ofauchon/oflmotes/README.md

# oflmotes

New 802.15.4 Sensor Network Framework.
OFLmotes is is the sucessor of OFLmetrics project. 

It's a full rewrite of both embedded firmwares and server code. 
It's now based on RIOT-OS, Golang.
