ofauchon/oflmotes/mote-devboard/README.md

# v1.0 Hardware 

First design, proof of concept.

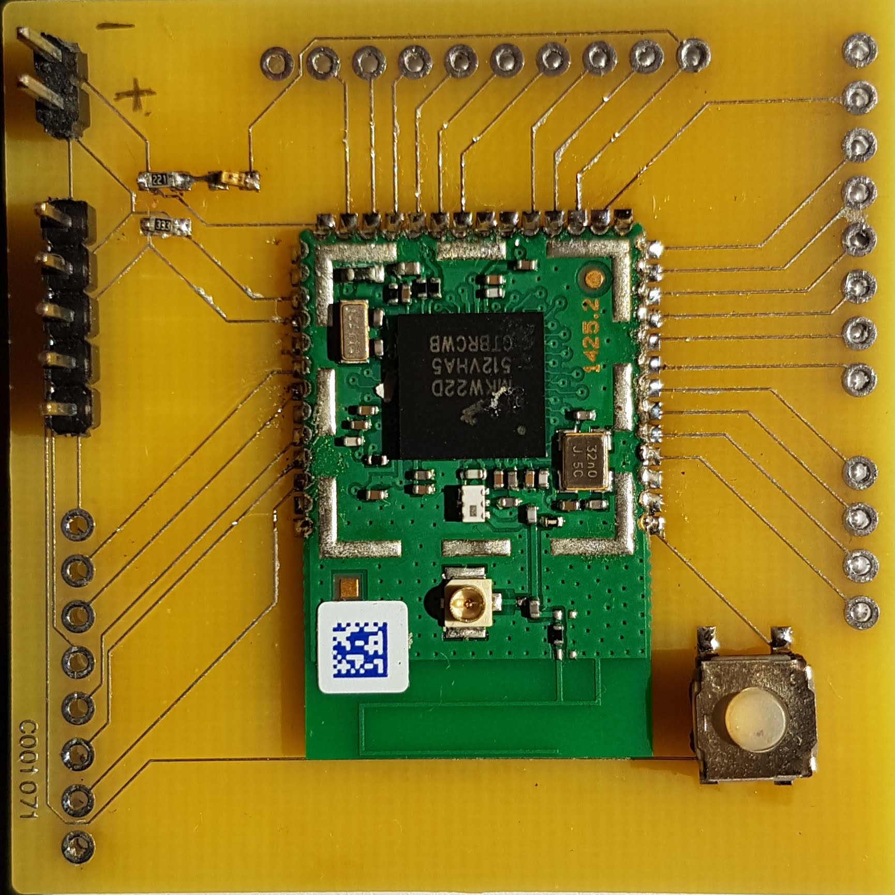
[picture p1: mote-devboard/res/board_v1.0.jpg]
v1.0 board picture


# v2.0 Hardware
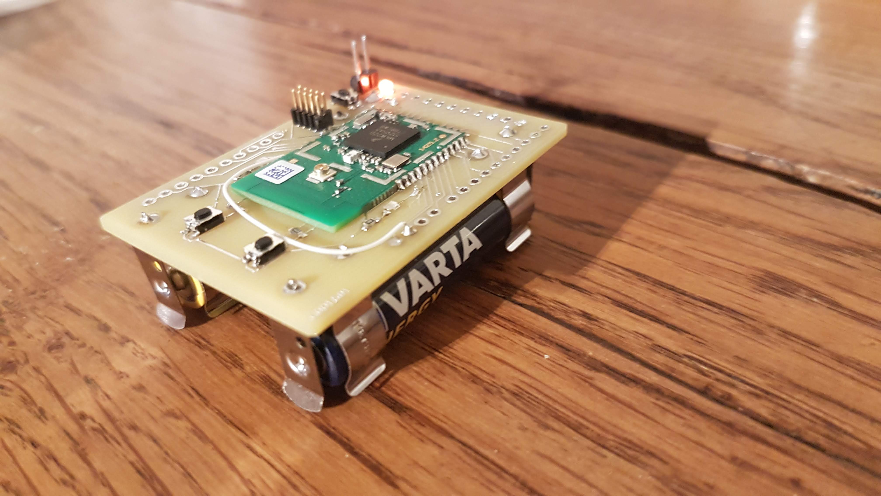
[picture p2: mote-devboard/res/board_v2.0.jpg]
v2.0 board picture

<!--<img src="kw2xd_module_pinout.png" alt="KW2xD module pinout" width="400px"/>-->

Enhancements: 

- 1 Led connected to power
- 2 Leds connected to GPIO
- 2 Buttons connected to GPIO
- Reduced board size
- AAA Batteries Support
