ofauchon/oflmotes/mote-devboard/circuit/v2/README.md

v2.0

  - New design with more led, buttons, AAA Batteries

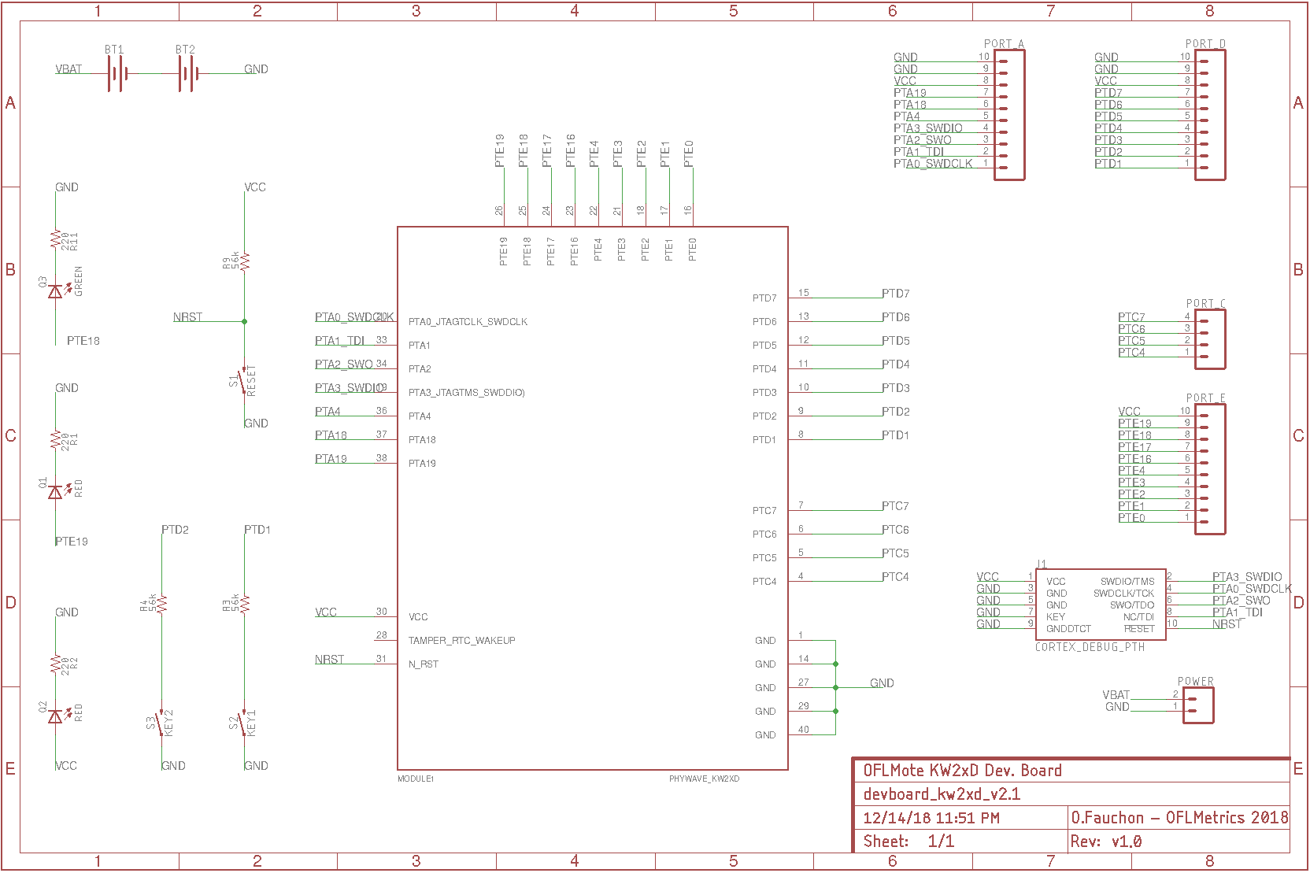
[picture p3: mote-devboard/circuit/v2/devboard_kw2xd_circuit_v2.0.png]
v2.0 board circuit

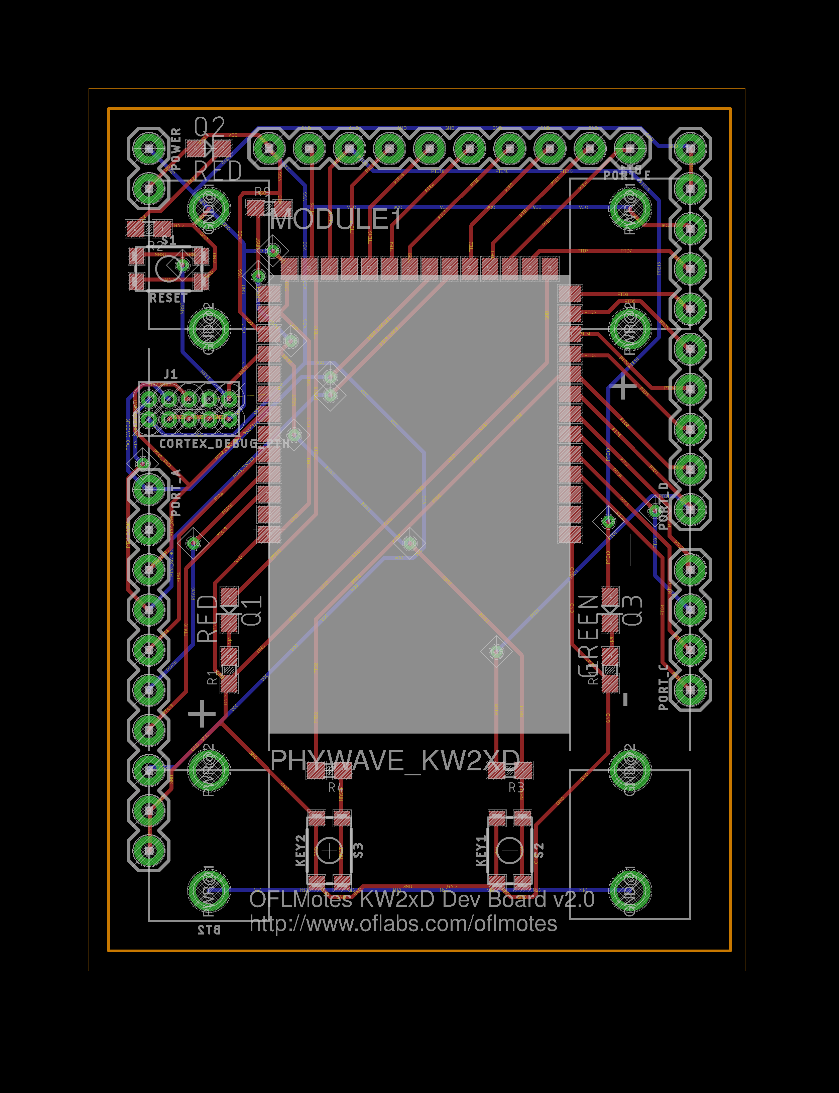
[picture p4: mote-devboard/circuit/v2/devboard_kw2xd_board_v2.0.png]
v2.0 board


Manufactured batch of 5 boards on nov 2018.

v2.1 (Work in progress) 

  - Add Restrict / Keepouts areas on Phynode module
  - Don't use  PTE18/PTE19 for LED1/2 as it can't be used as  GPIO :-(  
  - Top Left 2 pin headers can be used to switch on/off or for current measurement

v2.1 board circuit
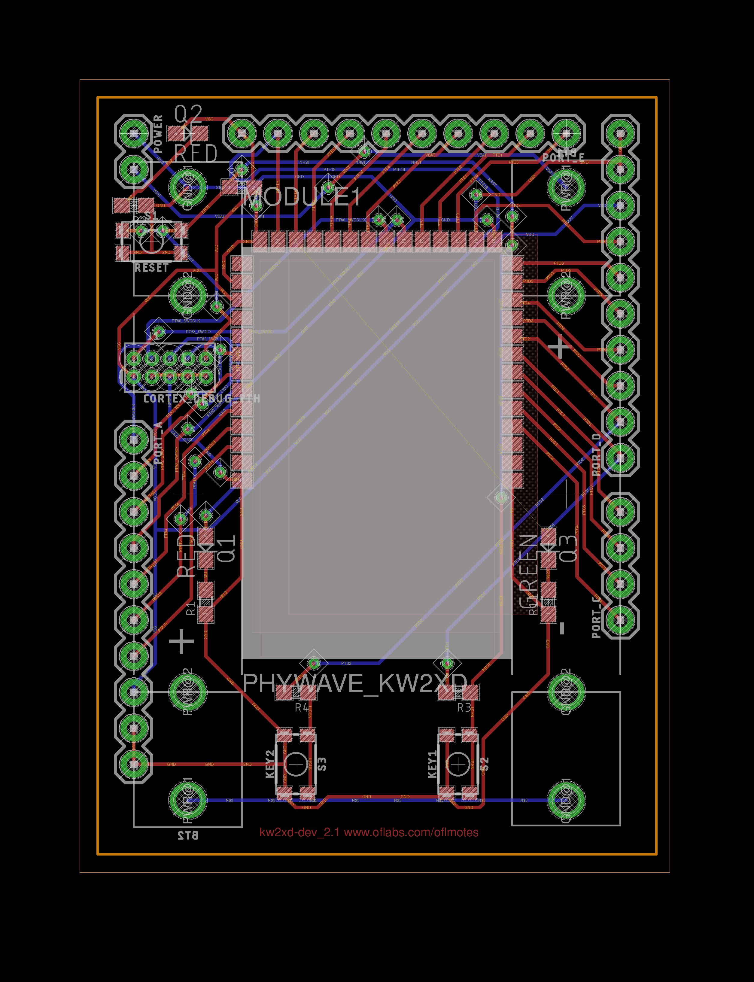
[picture p5: mote-devboard/circuit/v2/devboard_kw2xd_board_v2.1.png]
v2.1 board
