ofauchon/oflmotes/mote-devboard/res/kw2xd_module_pinout.png

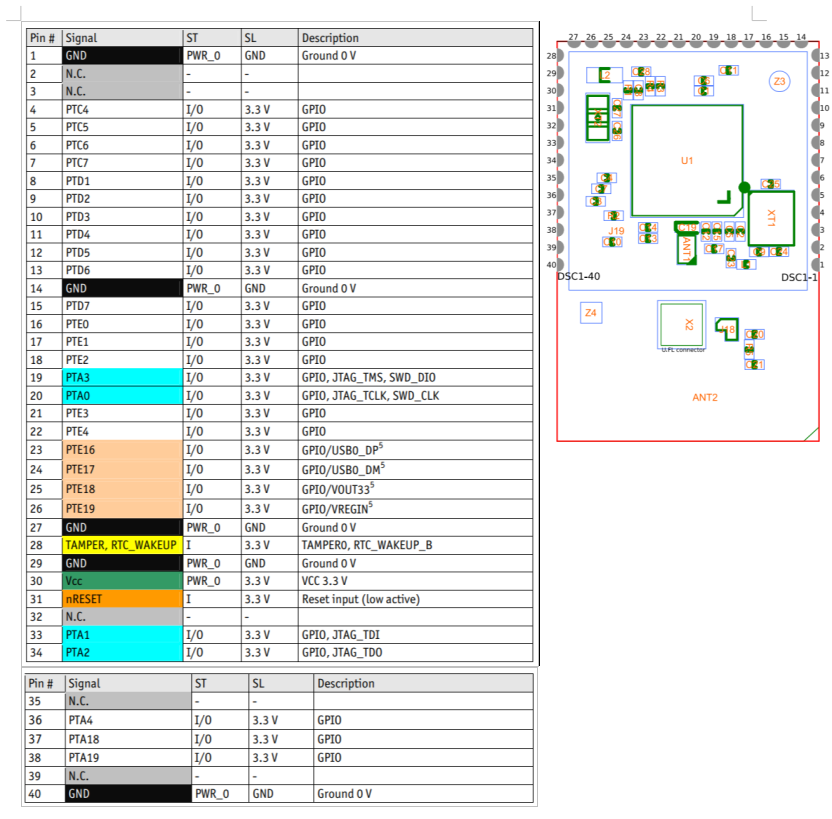
mote-devboard/res/kw2xd_module_pinout.png
