ofauchon/oflmotes/mote-devboard/circuit/v2/devboard_kw2xd_v2.1.brd

## EAGLE design mote-devboard/circuit/v2/devboard_kw2xd_v2.1.brd (2019-01-01)

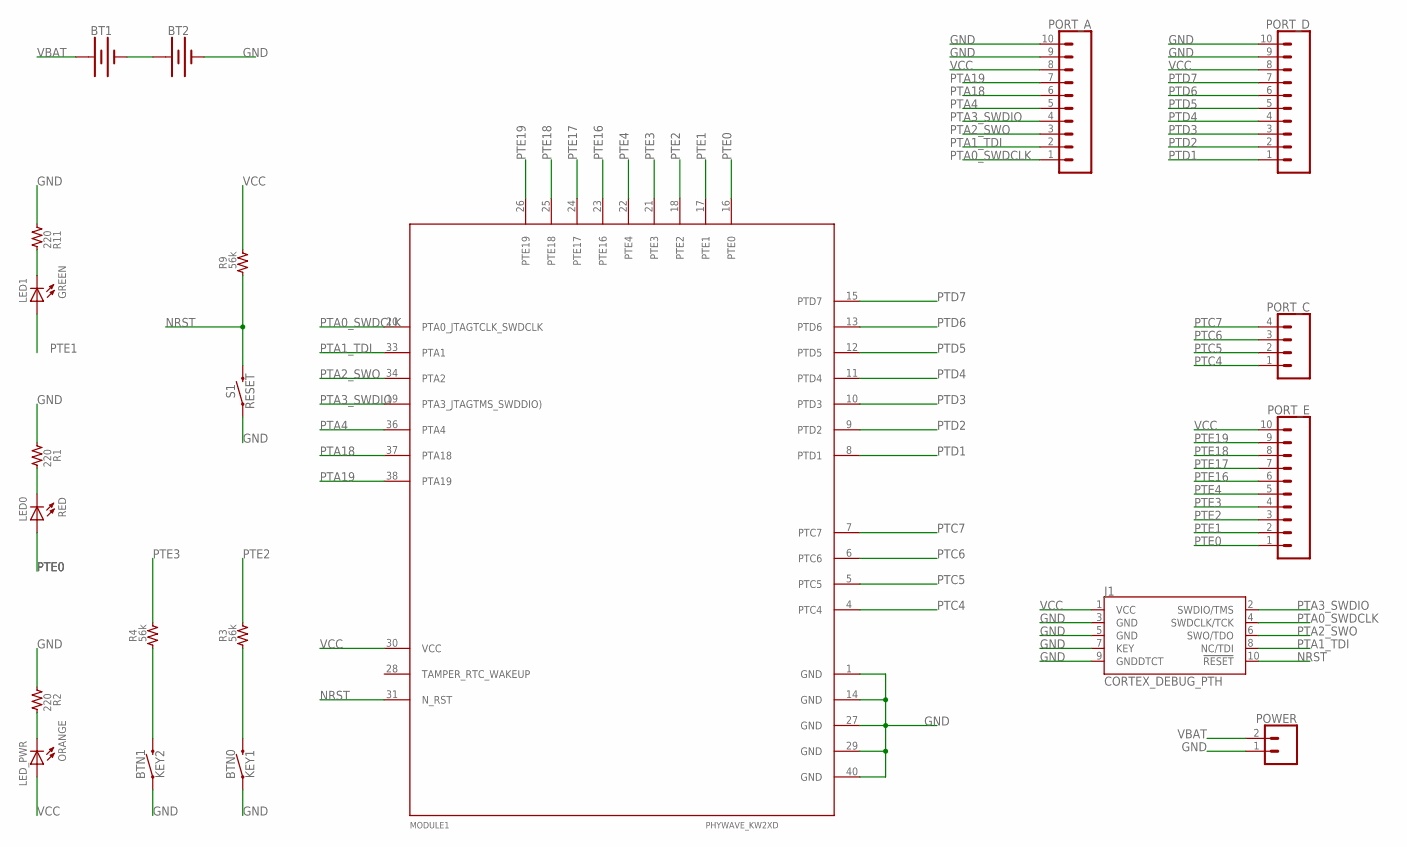
[picture p7: schematic devboard_kw2xd_v2.1.sch]

Parts:
BT1, BT2: BATTERY-AAA
BTN0: KEY1; TACTILE_SWITCH_SMD_4.6X2.8MM
BTN1: KEY2; TACTILE_SWITCH_SMD_4.6X2.8MM
J1: CORTEX_DEBUG_PTH; 2X5-PTH-1.27MM
LED0: RED; LED0603
LED1: GREEN; LED0603
LED_PWR: ORANGE; LED0603
MODULE1: PHYWAVE_KW2XD
PORT_A: CONN_10"; 1X10
PORT_C: CONN_04; 1X04
PORT_D: CONN_10"; 1X10
PORT_E: CONN_10"; 1X10
POWER: CONN_02; 1X02
R1, R2, R11: 220; SMD0603
R3, R4, R9: 56k; SMD0603
S1: RESET; TACTILE_SWITCH_SMD_4.6X2.8MM

Connections:
GND: BT2.GND@1 (-), BTN0.1, BTN0.2 (1), BTN1.1, BTN1.2 (1), J1.3 (GND), J1.5 (GND), J1.7 (KEY), J1.9 (GNDDTCT), MODULE1.1 (GND), MODULE1.14 (GND), MODULE1.27 (GND), MODULE1.29 (GND), MODULE1.40 (GND), PORT_A.9, PORT_A.10, PORT_D.9, PORT_D.10, POWER.1, R1.1, R2.1, R11.1, S1.1, S1.2 (1)
unnamed: LED0.C, R1.2
unnamed: LED_PWR.C, R2.2
unnamed: BT1.GND@1 (-), BT2.PWR@1 (+)
unnamed: LED1.C, R11.2
NRST: BTN0.3 (2), BTN0.4 (2), J1.10 (!RESET), MODULE1.31 (N_RST), R3.1, R9.1, S1.3 (2), S1.4 (2)
NRST1: BTN1.3 (2), BTN1.4 (2), R4.1
PTA0_SWDCLK: J1.4 (SWDCLK/TCK), MODULE1.20 (PTA0_JTAGTCLK_SWDCLK), PORT_A.1
PTA1_TDI: J1.8 (NC/TDI), MODULE1.33 (PTA1), PORT_A.2
PTA2_SWO: J1.6 (SWO/TDO), MODULE1.34 (PTA2), PORT_A.3
PTA3_SWDIO: J1.2 (SWDIO/TMS), MODULE1.19 (PTA3_JTAGTMS_SWDDIO)), PORT_A.4
PTA4: MODULE1.36 (PTA4), PORT_A.5
PTA18: MODULE1.37 (PTA18), PORT_A.6
PTA19: MODULE1.38 (PTA19), PORT_A.7
PTC4: MODULE1.4 (PTC4), PORT_C.1
PTC5: MODULE1.5 (PTC5), PORT_C.2
PTC6: MODULE1.6 (PTC6), PORT_C.3
PTC7: MODULE1.7 (PTC7), PORT_C.4
PTD1: MODULE1.8 (PTD1), PORT_D.1
PTD2: MODULE1.9 (PTD2), PORT_D.2
PTD3: MODULE1.10 (PTD3), PORT_D.3
PTD4: MODULE1.11 (PTD4), PORT_D.4
PTD5: MODULE1.12 (PTD5), PORT_D.5
PTD6: MODULE1.13 (PTD6), PORT_D.6
PTD7: MODULE1.15 (PTD7), PORT_D.7
PTE0: LED0.A, MODULE1.16 (PTE0), PORT_E.1
PTE1: LED1.A, MODULE1.17 (PTE1), PORT_E.2
PTE2: MODULE1.18 (PTE2), PORT_E.3, R3.2
PTE3: MODULE1.21 (PTE3), PORT_E.4, R4.2
PTE4: MODULE1.22 (PTE4), PORT_E.5
PTE16: MODULE1.23 (PTE16), PORT_E.6
PTE17: MODULE1.24 (PTE17), PORT_E.7
PTE18: MODULE1.25 (PTE18), PORT_E.8
PTE19: MODULE1.26 (PTE19), PORT_E.9
VBAT: BT1.PWR@1 (+), POWER.2
VCC: J1.1 (VCC), LED_PWR.A, MODULE1.30 (VCC), PORT_A.8, PORT_D.8, PORT_E.10, R9.2

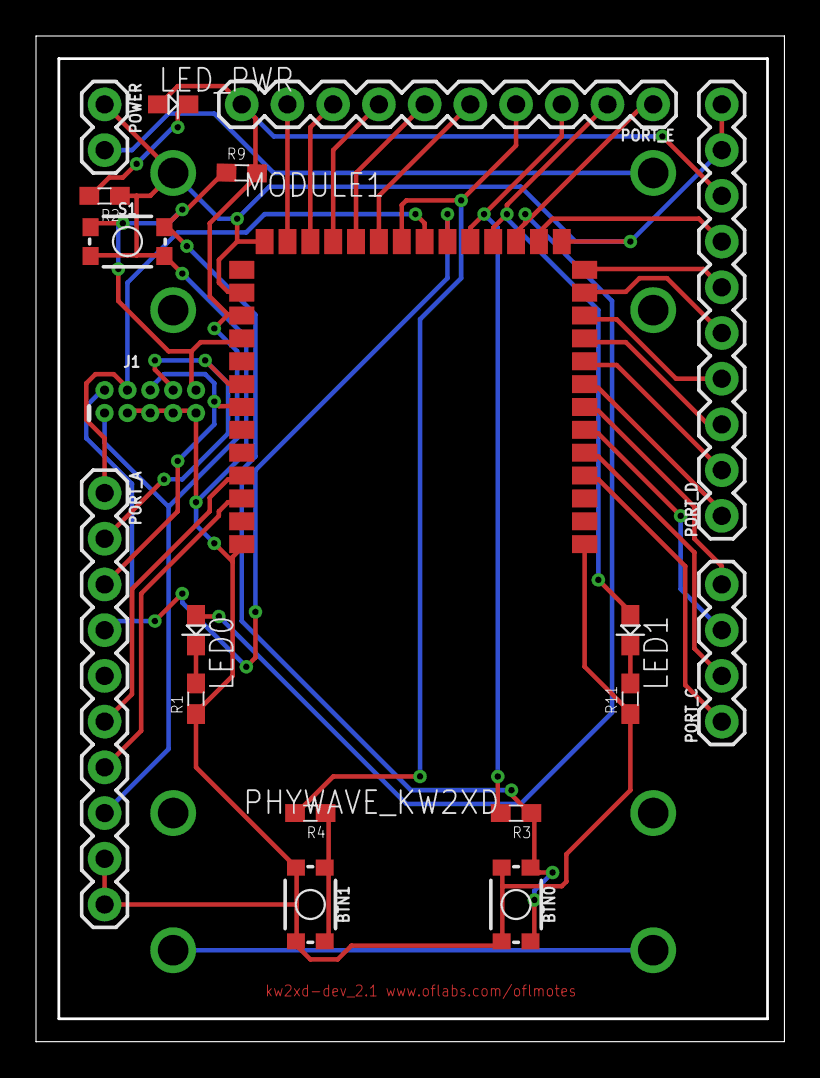
[picture p8: board devboard_kw2xd_v2.1.brd from above]

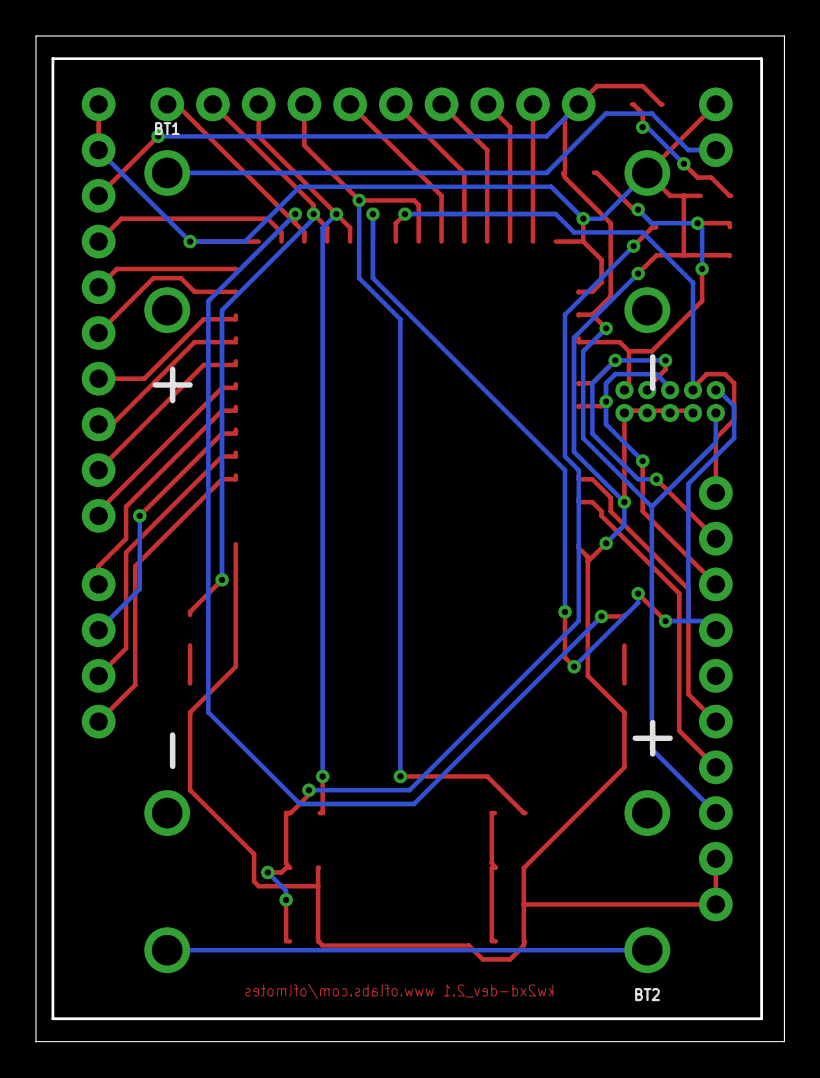
[picture p9: board devboard_kw2xd_v2.1.brd from below]

Board: 2 copper layers, 41.6 x 55.9 mm, 21 parts (2 on the bottom side), 36 nets.
