ofauchon/oflmotes/mote-sensors/mote-teleinfo/main.c

/*
 * Copyright (C) 2018, Olivier Fauchon <ofauchon2204@gmail.com>

 * This file is subject to the terms and conditions of the GNU Lesser
 * General Public License v2.1. See the file LICENSE in the top level
 * directory for more details.
 */

/**
 * @ingroup     nogroup
 * @{
 *
 * @file
 * @brief       802.15.4 Teleinfo Mote Sensor
 *
 * @author      Olivier Fauchon <ofauchon2204@gmail.com>
 *
 * @}
 */

#include <stdio.h>
#include <string.h>

#include "board.h"
#include "periph_conf.h"

#include "thread.h"
#include "timex.h"
#include "xtimer.h"

#include "net/gnrc/netif.h"
#include "net/gnrc/netapi.h"
#include "net/netopt.h"
#include "net/gnrc/pkt.h"
#include "net/gnrc/pktbuf.h"
#include "net/gnrc/netreg.h"
#include "net/gnrc/netif/hdr.h"
#include "net/netstats.h"

#include "ringbuffer.h"
#include "strings.h"

#include "periph/uart.h"
#include "periph/gpio.h"
#include "periph/hwrng.h"
#include "periph/adc.h"

#define CYCLE_PAUSE_SEC 60
#define READ_DELAY 10

#define UART_BUFSIZE        (128U)

static uint8_t loop_cntr; 

// Node ID must be passed at compilation time
// Todo Use EEPROM for NodeID definition
#ifndef NODE_ID
#error 'NODE_ID is undefined'
#endif

typedef struct
{
  char rx_mem[UART_BUFSIZE];
  ringbuffer_t rx_buf;
} uart_ctx_t;
static uart_ctx_t ctx[UART_NUMOF];

typedef struct
{
  int16_t papp;
  int16_t iinst;
  int32_t base;
} results_t;
static results_t results;

static kernel_pid_t ifpid = 0;
static uint8_t cur_pitinfo = 0 ; 

/* Blink led thread */
#define BLINKER_PRIO        (THREAD_PRIORITY_MAIN - 2)
static kernel_pid_t blinker_pid;
static char blinker_stack[THREAD_STACKSIZE_MAIN];

/* Processor thread */
#define PROCESSOR_PRIO        (THREAD_PRIORITY_MAIN - 1)
static kernel_pid_t processor_pid;
static char processor_stack[THREAD_STACKSIZE_MAIN];

/* Main thread */
static kernel_pid_t main_pid;

/*
 * Send 802.16.4 frame 
 */
static int data_tx (char *data, char data_sz)
{
  printf("data_tx: %s\r\n", data);

  uint8_t src[] = { 0x00, 0x00, 0x00, 0x00, 0x00, 0x00, 0x00, NODE_ID };
  uint8_t dst[] = { 0x00, 0x00, 0x00, 0x00, 0x00, 0x00, 0x00, 0x01 };

  gnrc_pktsnip_t *pkt, *hdr;

  // put packet together 
  pkt = gnrc_pktbuf_add (NULL, data, data_sz, GNRC_NETTYPE_UNDEF);
  if (pkt == NULL)
    {
      puts ("error: packet buffer full");
      return 1;
    }

  hdr = gnrc_netif_hdr_build (src, sizeof (src), dst, sizeof (dst));
  if (hdr == NULL)
    {
      puts ("error: packet buffer full");
      gnrc_pktbuf_release (pkt);
      return 1;
    }
  LL_PREPEND (pkt, hdr);
  // and send it 
  if (gnrc_netapi_send (ifpid, pkt) < 1)
    {
      puts ("error: unable to send");
      gnrc_pktbuf_release (pkt);
      return 1;
    }
  return 1;
}


/*
 * Thread for led blinking 
 */
static void* blinker_thread (void *arg)
{
  (void) arg;
  msg_t msg;
  msg_t msg_queue[8];
  msg_init_queue (msg_queue, 8);
  while (1)
    {
      // 
      msg_receive (&msg);
      LED1_ON;
      xtimer_sleep(1);
      LED1_OFF;
      xtimer_sleep(1);
    }
  return NULL;
}


/*
 * Processor Thread 
 * 
 * Loop and process messages from UART.
 * Append new uart char to a ringbuffer
 * Send message to 
 */
static void* processor_thread (void *arg)
{
  (void) arg;
  msg_t msg;
  msg_t msg_queue[8];
  msg_init_queue (msg_queue, 8);
  char buffer[UART_BUFSIZE];

  while (1)
  {
    msg_receive (&msg);
    uart_t dev = (uart_t) msg.content.value;
    bzero (buffer, sizeof (buffer));
    ringbuffer_get (&(ctx[dev].rx_buf), buffer, UART_BUFSIZE);

    printf("processor_thread: RX '%s'\n", buffer); 

    //'BASE 014038982 .'
    if (strncmp (buffer, "BASE", 4) == 0 && strlen (buffer) >= 14)
    {
       buffer[14] = 0;
       results.base = atoi (buffer + 5);
    }
    //'PAPP 02340 *'
    else if (strncmp (buffer, "PAPP", 4) == 0 && strlen (buffer) >= 10)
    {
      buffer[10] = 0;
      results.papp = atoi (buffer + 5);
    }
    //'IINST 010 X'
    else if (strncmp (buffer, "IINST", 5) == 0 && strlen (buffer) >= 9)
    {
      buffer[9] = 0;
      results.iinst = atoi (buffer + 6);
    }

    if (results.papp >= 0 && results.iinst >= 0 && results.base >= 0)
    {
      bzero (buffer, sizeof (buffer));
      sprintf (buffer, "PAPP%d:%i;BASE%d:%li;IINST%d:%i", 
        cur_pitinfo, results.papp,
        cur_pitinfo, results.base, 
        cur_pitinfo, results.iinst);
      printf ("=> %s \r\n", buffer);
      data_tx (buffer, strlen (buffer));

      // Notify Blinker
      msg_t msg;
      msg.content.value = 1;
      msg_send (&msg, blinker_pid);

      results.papp = results.base = results.iinst = 0;

      // Stop serial port
      uart_poweroff (UART_DEV (1));

    }
  }

  /* this should never be reached */
  return NULL;
}


/* 
 * UART RX Callback function
 *
 * Discart 8th bit as PitInfo Teleinformation interface is 7N1
 * Append new char to ringbuffer
 * If new char is newline, send a message to processor thread
 */
static void rx_cb (void *arg, uint8_t data)
{
  uart_t dev = (uart_t) arg;
  data &= 0x7F;

  if (data == '\n')
    {
      msg_t msg;
      msg.content.value = (uint32_t) dev;
      msg_send (&msg, processor_pid);
    }
  else if (data >= ' ')
    {
      ringbuffer_add_one (&(ctx[dev].rx_buf), data);
    }
}


/*
 * Wrapper to gnrc_netapi_set RIOT-OS 
 * 
 */
static int netapi_set (kernel_pid_t pid, netopt_t opt, uint16_t context, void *data,
	    size_t data_len)
{
  int ret;
  ret = gnrc_netapi_set (pid, opt, context, data, data_len);
  if (ret < 0)
    {
      printf ("!: netapi_set: Can't set option\r\n");
    }
  return ret;
}

/*
 * HW Initialisation
 */ 
static void prepare_all (void)
{

  printf ("Start HW init\r\n");
  uint8_t out[GNRC_NETIF_L2ADDR_MAXLEN];

  /* initialize UART */
  for (unsigned i = 0; i < UART_NUMOF; i++) // Init ringbuffers for all UARTs
    {
      ringbuffer_init (&(ctx[i].rx_buf), ctx[i].rx_mem, UART_BUFSIZE);
    }

  int res;
  int dev = 1;
  res = uart_init (UART_DEV (1), 1200, rx_cb, (void *) dev);
  if (res != UART_OK)
    {
      puts ("Error: Unable to initialize UART device\r\n");
      return;
    }
  printf ("Successfully initialized UART_DEV(%i)\r\n", dev);

  /* initialize Network */
  gnrc_netif_t *iff = NULL;
  iff = gnrc_netif_iter (iff);
  if (iff == NULL)
    {
      printf ("ERROR : NO INTERFACE \r\n");
      return;
    }
  ifpid = iff->pid;

  printf ("Switch to chan 11\r\n");
  int16_t val = 11;
  netapi_set (iff->pid, NETOPT_CHANNEL, 0, (int16_t *) & val,
	      sizeof (int16_t));

  // Set PAN to 0xF00D
  printf ("Set pan to 0xF00D\r\n");
  val = 0xF00D;
  netapi_set (iff->pid, NETOPT_NID, 0, (int16_t *) & val, sizeof (int16_t));

  // Set address
  printf ("Set addr to 00:...:99\r\n");
  char src[24];
  sprintf (src, "00:00:00:00:00:00:00:%02x", NODE_ID);

  size_t addr_len = gnrc_netif_addr_from_str (src, out);
  if (addr_len == 0)
    {
      printf ("!!! Unable to parse address !!!\r\n");
    }
  else
    {
      printf ("!!! addr len %d !!!\r\n", addr_len);
      netapi_set (iff->pid, NETOPT_ADDRESS_LONG, 0, out, sizeof (out));
    }

  printf ("Done HW init\r\n");
}

      


/*
 * Use bandgap reference and ADC to measure board's voltage
 */
int getBat(void){
  // Enable bandgap reference for battery
  PMC->REGSC |= 1;
  // Init ADC line 6
  adc_init(ADC_LINE(6));
  int sample = adc_sample(ADC_LINE(6), ADC_RES_10BIT);
  int mv = (int)(1024*1000/sample);
  PMC->REGSC &= (uint8_t) ~1;
  return mv;
}


int main (void)
{

  // INIT
  printf("*** OFlabs 802.15.4 OFLMote Sensor - Teleinfo ***\r\n");
  //  printf("*** Riot Release     %s\r\n", RIOTVERSION);
  printf("*** OFlMotes Release %s\r\n", MOTESVERSION);
  prepare_all ();

  loop_cntr=0; 
 

  /* start the blinker thread */
  blinker_pid = thread_create (blinker_stack, sizeof (blinker_stack),
			       BLINKER_PRIO, 0,
			       blinker_thread, NULL, "blink_thread");

  /* start the processor thread */
  processor_pid = thread_create (processor_stack, sizeof (processor_stack),
				 PROCESSOR_PRIO, 0,
				 processor_thread, NULL, "processor_thread");

  // Initialize PTE2 and PTE3 as output to power-on PitInfo(s)
  gpio_init(GPIO_PIN(PORT_E, 2), GPIO_OUT);
  gpio_init(GPIO_PIN(PORT_E, 3), GPIO_OUT);

  main_pid=thread_getpid();


  // Blink 3 times at start
  int j;
  for (j=0;j<3; j++){
  msg_t msg;
  msg.content.value = 1;
  msg_send (&msg, blinker_pid);
  }

  char buffer[UART_BUFSIZE]; // Todo: move me 
  while (1)
    {
        // Enable Radio for TX
        netopt_state_t state;
        state = NETOPT_STATE_TX;
        netapi_set (ifpid, NETOPT_STATE, 0, &state , sizeof (state));

        // Periodic misc info TX (battery level ...)
        if ((loop_cntr % 5)==0){
            sprintf (buffer, "DEVICE:TELEINFO;VER=1;BATLEV:%d", getBat());
            data_tx (buffer, strlen (buffer));
        }

        // Read PitInfo #1
        printf("Start read PiTInfo #1\r\n");
        cur_pitinfo=1;
        results.base = -1;
        results.iinst = -1;
        results.papp = -1;
        gpio_set(GPIO_PIN(PORT_E,2));
        uart_poweron (UART_DEV (1));
        xtimer_sleep(READ_DELAY); //Wait fo 5 seconds for data process
        uart_poweroff(UART_DEV (1));
        gpio_clear(GPIO_PIN(PORT_E,2));
        printf("End read PiTInfo #1\r\n");

        // Read PitInfo #2
        printf("Start Read PiTInfo #2\r\n");
        cur_pitinfo=2;
        results.base = -1;
        results.iinst = -1;
        results.papp = -1;
        gpio_set(GPIO_PIN(PORT_E,3));
        uart_poweron (UART_DEV (1));
        xtimer_sleep(READ_DELAY); //Wait fo 5 seconds for data process
        uart_poweroff(UART_DEV (1));
        gpio_clear(GPIO_PIN(PORT_E,3));
        printf("End read PiTInfo #2\r\n");

        // Powersave (Disable Radio)
        state = NETOPT_STATE_OFF;
        netapi_set (ifpid, NETOPT_STATE, 0, &state , sizeof (state));
        printf("Hibernate\r\n");
        xtimer_sleep (CYCLE_PAUSE_SEC);
        loop_cntr++; 

    }
}
