ofauchon/oflmotes/(commit log)

2017-10-19 Code cleanup and fixes. Packet RX dump works now
    [main.c, myutils.c, myutils.h, pktdump.c]
2017-10-21 Command line for influxdb configuration and frames parsing
2017-10-21 Fix for TEMP metric decoding in frame, and properly handling influxdb types
2017-10-27 Switch to 802.15.4 extended addressing (64bits) both hard and soft code
2017-10-29 Revert smac/dmac byte order
    [main.c]
2018-03-04 Code fixups due to RIOT API Changes
    [main.c, myutils.c, pktdump.c]
2018-03-05 Bugfix when interface iteration
    [main.c]
2018-03-09 First attempt to use Riot and pba-d-01-kw2x as teleinfo sensor
2018-03-15 Code cleanup, and fixes. Almost works but still WIP
    [main.c]
2018-03-27 Reorganize source code for sensors
2018-04-17 Initial changes to use rtt_timer in replacement of xtimer for better powersave
    [main.c]
2018-04-27 - Added battery voltage measurement
2018-05-05 Add periodic transmission of technical informations like type of device, version, battery level
2018-06-13 First Eagle PCB developpement board based on phyWAVE-KW2xD module
    [devboard_kw2xd_v1.0.sch]
2018-06-14 - Add .brd board layout file
    [devboard_kw2xd_v1.0.brd, devboard_kw2xd_v1.0.sch]
2018-06-14 -Increased clearances from 6 to 8mil to fit Eurocircuits PCB Manufacturer's requirements - Order a first batch of 2 naked prototype boards
    [devboard_kw2xd_v1.0.brd]
2018-08-06 Added schematic and board pdf
2018-08-16 Picture of v1.0 board
2018-08-16 Added picture of v1.0 board
2018-10-31 Added RIOT local board definition and a couple of examples
2018-11-08 Moved Eagle files to circuit/
    [devboard_kw2xd_v1.0.brd, devboard_kw2xd_v1.0.sch]
2018-11-11 Versionning the current circuit design to v1
    [devboard_kw2xd_v1.0.brd, devboard_kw2xd_v1.0.sch]
2018-11-14 Board v2
    [devboard_kw2xd_v2.0.brd, devboard_kw2xd_v2.0.sch]
2018-12-09 - Fix RSSI values in pktdump - Code indent
    [main.c, myutils.c, myutils.h, pktdump.c, pktdump.h]
2018-12-14 2-pin header (upper left) will be used as power switch/current meter
    [devboard_kw2xd_v2.1.brd, devboard_kw2xd_v2.1.sch]
2018-12-14 - Board References moved to top copper layer
    [devboard_kw2xd_v2.1.brd]
2018-12-14 Added v2 circuit
2018-12-14 Added board pcb
2018-12-14 Higher resolution for board pcb
2018-12-14 Added v2.1 circuit and pcb images
2018-12-17 Fix typo : Both buttons can be used to activate safeguard
    [board.c]
2018-12-19 Use i2c0 PE18/PE19 instead of i2c1 PE0/PE1
2018-12-19 Change LED/PIN to PTE0/1/2/3
2018-12-20 LED OFF at boot
2019-01-01 Changed cpu mode to FEI so we don't rely on radio clock Minor changes in board design
    [devboard_kw2xd_v2.1.brd, devboard_kw2xd_v2.1.sch]
2019-01-01 Revert i2c pin change
    [periph_conf.h]
2019-01-01 Revert i2c pin change (forgot the MUX in previous commit)
    [periph_conf.h]
2019-01-01 Change LEDs pin from PE0/PE1 to PD5/PD4 to free i2c ports (PE0/PE1)
2019-01-02 Remove unused, conflicting code PE2/PE3 are not anymore used to power up i2c device
2019-01-06 Removed blinker thread, and don't turn off radio
2019-01-08 Added DEFINEs for Radio Sleep and power management
2019-01-08 Renamed powersave defines
2019-01-09 Build information display fixes
    [main.c]
2019-01-09 Fix powersave bug
2019-01-22 Set max radio tx power
2019-01-29 Added Serial Read traces
2019-01-30 Minor changes (comments, leds usage)
2019-03-22 Traces DEBUGs
2019-03-31 Dual teleinfo support fixes
    [main.c, teleinfo.c, teleinfo.h]
2019-04-01 Replace multiple UART probing with one single multiplexed UART
    [main.c, teleinfo.c, teleinfo.h]
2019-04-02 - Fixed state checks - Enhanced logs
    [main.c, teleinfo.c]
2019-06-18 Project Tree cleanup
    [devboard_kw2xd_v1.0.brd, devboard_kw2xd_v1.0.sch, devboard_kw2xd_v2.0.brd, devboard_kw2xd_v2.0.sch, devboard_kw2xd_v2.1.brd, devboard_kw2xd_v2.1.sch]
2019-07-13 Add OpenOCD ftdi config fime
    [ftdi.cfg]
2019-07-14 Moved ftdi openocd config, create app/tests
    [ftdi.cfg]
2019-07-20 Update boads Makefile.features according to RIOT's pba-d-01-kw2x board
2019-08-16 Update UART llwu_rx PIN definition
2019-08-16 Added custom openocf.cfg to oflomde-dev board definition
